Colin-Lundquist/trailTracerDocumentation/Images/batt schem.PNG

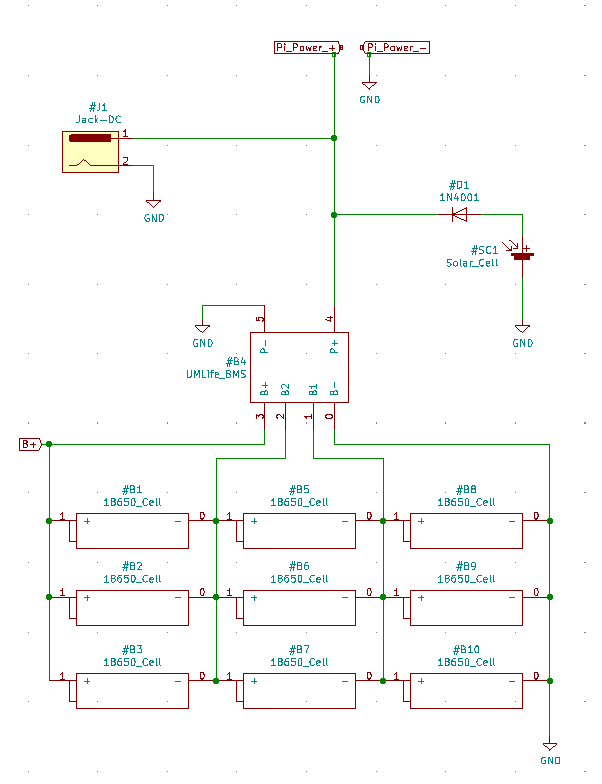
Images/batt schem.PNG
