Colin-Lundquist/trailTracerDocumentation/Images/Capture.PNG

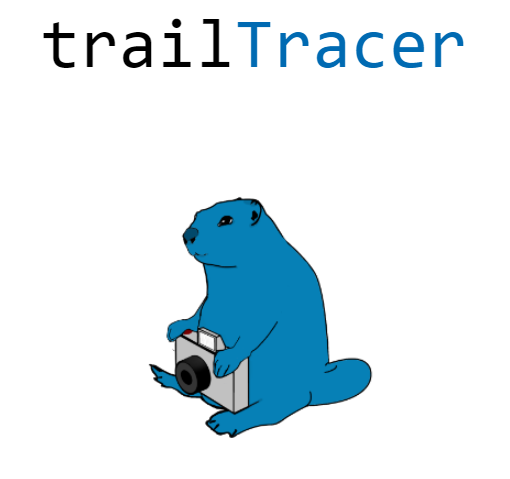
Images/Capture.PNG
