Colin-Lundquist/trailTracerDocumentation/Images/pcb.PNG

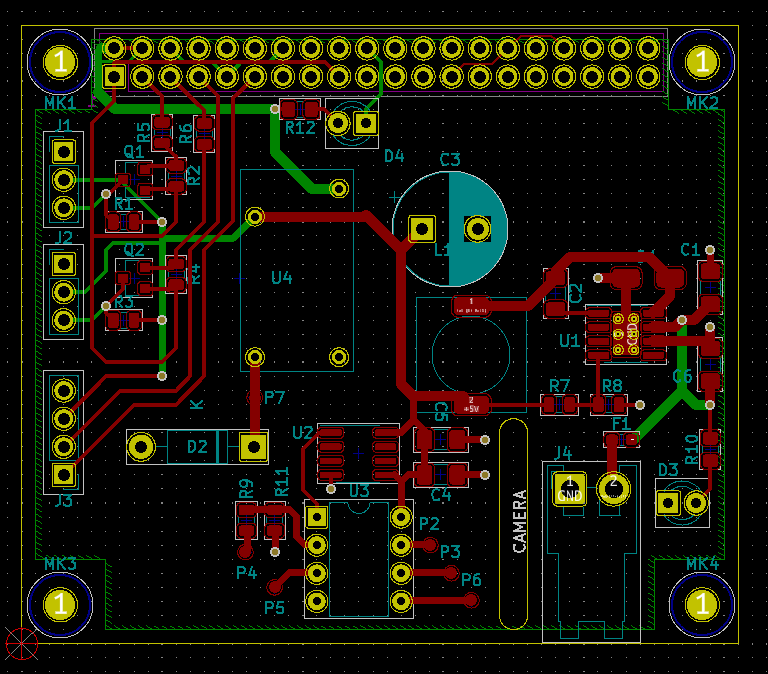
Images/pcb.PNG
