Colin-Lundquist/trailTracerDocumentation/KiCAD/PiHat/pihat/pihat.kicad_pcb

## KiCad design KiCAD/PiHat/pihat/pihat.kicad_pcb (2020-05-01)

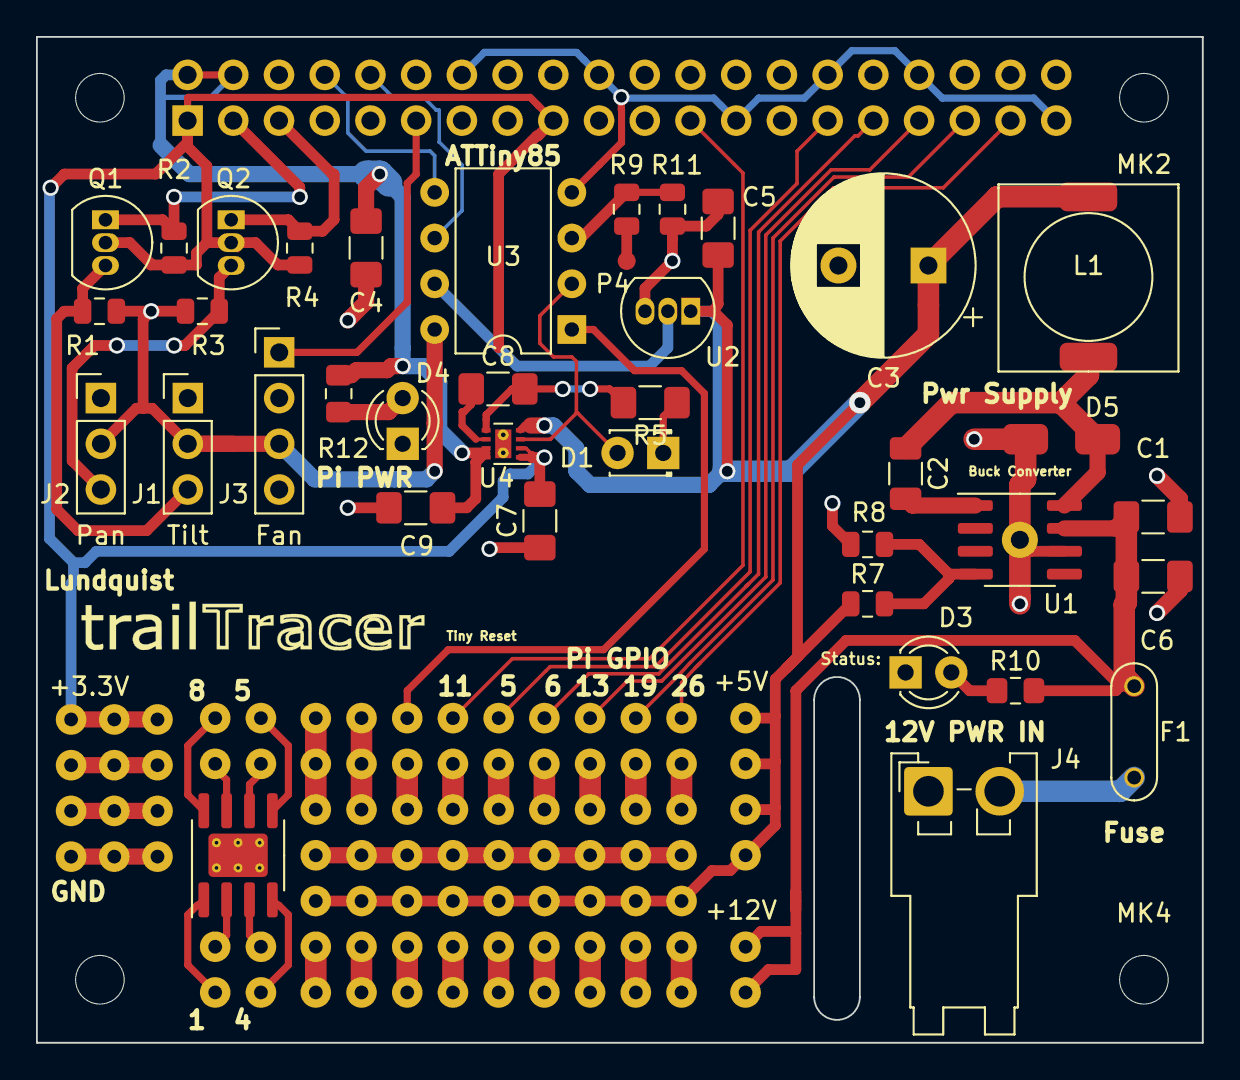
[picture p21: board pihat.kicad_pcb from above]

Board: 2 copper layers, 64.8 x 55.9 mm, 51 parts (1 on the bottom side), 31 nets.

Parts:
 : Hole
 #2: Hole
 #3,  #4: SOIC_IO
 #5: SOIC-8-1EP_3.9x4.9mm_P1.27mm_EP2.41x3.3mm_Thermal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; SOIC-8-1EP_3.9x4.9mm_P1.27mm_EP2.41x3.3mm_ThermalVias
 #6: Breadbord layout
 #7: M2.5; MountingHole_2.7mm_M2.5
+3.3V, +5V: Hole
+12V: Holes_2
C1, C6: 47 uF; C_1206_3216Metric_Pad1.42x1.75mm_HandSolder
C2: 10 nF; R_1206_3216Metric
C3: 270 uF; CP_Radial_D10.0mm_P5.00mm
C4, C5: 220 uF; C_1206_3216Metric_Pad1.42x1.75mm_HandSolder
C7: 100uF; R_1206_3216Metric_Pad1.42x1.75mm_HandSolder
C8: 220pF; R_1206_3216Metric_Pad1.42x1.75mm_HandSolder
C9: 10uF; R_1206_3216Metric_Pad1.42x1.75mm_HandSolder
D1: LED; LED_D1.8mm_W3.3mm_H2.4mm
D3, D4: LED; LED_D3.0mm
D5: B340
F1: Fuse; Fuse_Holder_TR5
J1: Pan Servo Connector; PinHeader_1x03_P2.54mm_Vertical
J2: Tilt Servo Connector; PinHeader_1x03_P2.54mm_Vertical
J3: Fan; PinHeader_1x04_P2.54mm_Vertical
J4: Power Connector; JST_VH_S2P-VH_1x02_P3.96mm_Horizontal
L1: 15 uH; SRR1050A Coil
MK1, MK2, MK4: M2.5; MountingHole_2.7mm_M2.5
P1: Conn_02x20_Odd_Even; PinSocket_2x20_P2.54mm_Vertical
P4: Pad
Q1, Q2: 2N7000; TO-92_Inline
R1, R2, R3, R4, R11: 10K; R_0805_2012Metric
R5: 220R; R_1206_3216Metric_Pad1.42x1.75mm_HandSolder
R7: 10 KOhm; R_0805_2012Metric
R8: 3.24 KOhm; R_0805_2012Metric
R9: 15K; R_0805_2012Metric
R10: 470; R_0805_2012Metric_Pad1.15x1.40mm_HandSolder
R12: 120R; R_0805_2012Metric_Pad1.15x1.40mm_HandSolder
U1: TPS5430-Q1; SOIC-8-1EP_3.9x4.9mm_P1.27mm_EP2.29x3mm_ThermalVias
U2: LMT87; TO-92_Inline
U3: ATTiny85; DIP-8_W7.62mm
U4: TPS22965; WSON-8-1EP_2x2mm_P0.5mm_EP0.9x1.6mm_ThermalVias

Connections:
+3V3: .1, #2.1, +3.3V.1, C7.2, P1.1, P1.17, Q1.2, Q2.2, R2.2, R4.2, U4.1, U4.2
+5V: .1, #2.1, #6.1, +3.3V.1, +5V.1, C3.1, C5.1, J1.2, J2.2, J3.3, L1.2, R1.2, R3.2, R7.1, U2.1, U3.8, U4.4
+12V: +12V.1, +12V.2, C1.1, C6.1, F1.2, R10.2, U1.7
/GPIO5: #6.1, P1.29
/GPIO6: #6.1, P1.31
/GPIO19(SPI1_MISO): #6.1, P1.35
/GPIO26: #6.1, P1.37
GND: .1, #2.1, #6.1, +3.3V.1, C1.2, C3.2, C4.2, C5.2, C6.2, C7.1, C8.2, C9.1, D3.1, D4.1, D5.2, J1.1, J2.1, J3.4, J4.1, P1.6, P1.9, P1.14, P1.20, P1.25, P1.30, P1.34, P1.39, R5.2, R8.2, R11.2, U1.6, U1.9, U2.3, U3.4, U4.5
GPIO_2: P1.3, Q1.1, R2.1
GPIO_3: P1.5, Q2.1, R4.1
GPIO_11: #6.1, P1.23
GPIO_13: #6.1, P1.33
GPIO_17: J3.1, P1.11
unnamed: C2.1, D5.1, L1.1, U1.8
unnamed: C2.2, U1.1
unnamed: C8.1, U4.6
unnamed: D1.1, R5.1
unnamed: D3.2, R10.1
unnamed: D4.2, R12.1
unnamed: F1.1, J4.2
unnamed: J1.3, Q1.3, R1.1
unnamed: J2.3, Q2.3, R3.1
unnamed: P4.1, R9.2
unnamed: R7.2, R8.1, U1.4
unnamed: R9.1, R11.1, U3.3
unnamed: #6.1, U3.1
PI_5V: C4.1, C9.2, P1.2, P1.4, R12.2, U4.7, U4.8
TINY_B0: P1.8, U3.5
TINY_B1: P1.10, U3.6
TINY_B2: U2.2, U3.7
TINY_B4: D1.2, U3.2, U4.3
