Colin-Lundquist/trailTracerDocumentation/(commit log)

2020-02-18 compacted servo design
    [pihat.kicad_pcb, pihat.sch]
2020-02-18 Added Fan Header
    [pihat.kicad_pcb, pihat.sch]
2020-02-24 Temporary Commit
    [pihat.kicad_pcb, pihat.sch]
2020-02-28 Minor commit
    [Power.sch, file5E570B6F.sch, pihat.kicad_pcb, pihat.sch]
2020-03-13 Added status LEDs, power relay, organized traces
    [Power.sch, pihat.kicad_pcb, pihat.sch]
2020-03-13 Peer review changes
    [Power.sch, pihat.kicad_pcb, pihat.sch]
2020-03-19 Revision 1
    [Power.sch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]
2020-04-10 Re-routing of components, fixed bugs from first spin
    [Power.sch, pihat.kicad_pcb, pihat.sch]
2020-05-01 Added MOSFET switch, Logo, Prototype area
    [noname.kicad_pcb, pihat.kicad_pcb, pihat.sch]
